devcat-jp/SplitKeyboard/(list of files, drawings)

Other design files:
KiCaD/KeyBoard_L/20240218_keyboard.dsn
KiCaD/KeyBoard_R/20240224_KeyBoard_R.dsn
