devcat-jp/SplitKeyboard/KiCaD/KeyBoard_L/20240218_keyboard.kicad_pcb

## KiCad design KiCaD/KeyBoard_L/20240218_keyboard.kicad_pcb (2024-03-23)

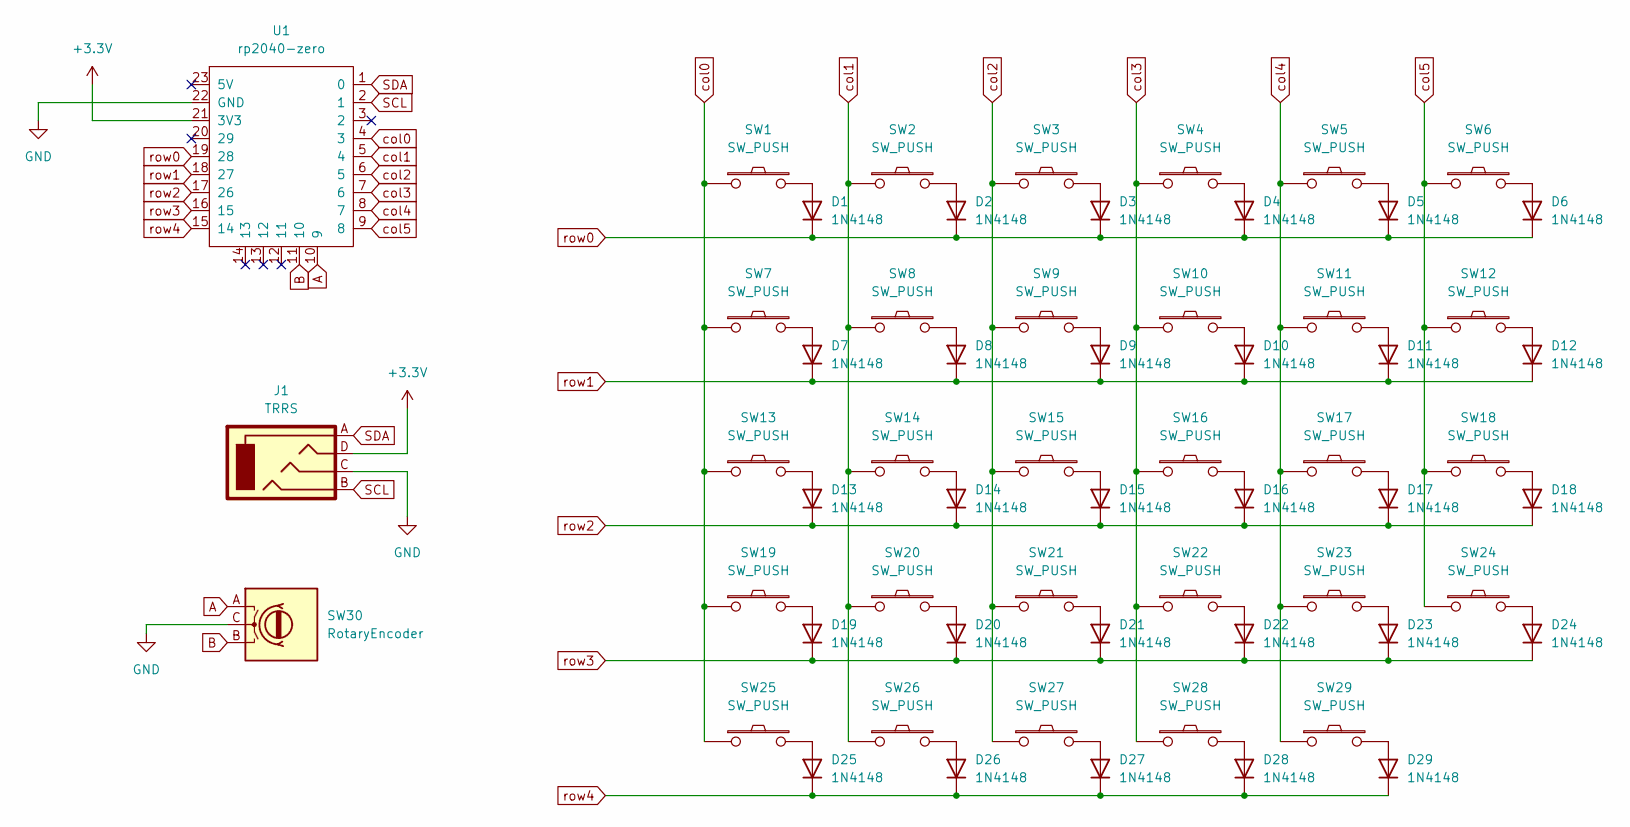
[picture p1: schematic 20240218_keyboard.kicad_sch]

Parts:
D1, D2, D3, D4, D5, D6, D7, D8, D9, D10, D11, D12, D13, D14, D15, D16, D17, D18, D19, D20, D21, D22, D23, D24, D25, D26, D27, D28, D29: 1N4148; D3_SMD_v2
J1: TRRS; MJ-4PP-9_1side
SW1, SW2, SW3, SW4, SW5, SW6, SW8, SW9, SW10, SW11, SW12, SW14, SW15, SW16, SW17, SW18, SW20, SW21, SW22, SW23, SW24, SW26, SW27, SW28: SW_PUSH; SW_Hotswap_Kailh_MX_1.00u
SW7: SW_PUSH; SW_Hotswap_Kailh_MX_1.25u
SW13, SW25, SW29: SW_PUSH; SW_Hotswap_Kailh_MX_1.50u
SW19: SW_PUSH; SW_Hotswap_Kailh_MX_1.75u
SW30: RotaryEncoder; RotaryEncoder_EC11-Switch
U1: rp2040-zero; rp2040-zero-tht

Connections:
+3.3V: J1.D, U1.21 (3V3)
A: SW30.A, U1.10 (9)
B: SW30.B, U1.11 (10)
GND: J1.C, SW30.C, U1.22 (GND)
unnamed: D1.2 (A), SW1.2
unnamed: D2.2 (A), SW2.2
unnamed: D3.2 (A), SW3.2
unnamed: D4.2 (A), SW4.2
unnamed: D5.2 (A), SW5.2
unnamed: D6.2 (A), SW6.2
unnamed: D7.2 (A), SW7.2
unnamed: D8.2 (A), SW8.2
unnamed: D9.2 (A), SW9.2
unnamed: D10.2 (A), SW10.2
unnamed: D11.2 (A), SW11.2
unnamed: D12.2 (A), SW12.2
unnamed: D13.2 (A), SW13.2
unnamed: D14.2 (A), SW14.2
unnamed: D15.2 (A), SW15.2
unnamed: D16.2 (A), SW16.2
unnamed: D17.2 (A), SW17.2
unnamed: D18.2 (A), SW18.2
unnamed: D19.2 (A), SW19.2
unnamed: D20.2 (A), SW20.2
unnamed: D21.2 (A), SW21.2
unnamed: D22.2 (A), SW22.2
unnamed: D23.2 (A), SW23.2
unnamed: D24.2 (A), SW24.2
unnamed: D25.2 (A), SW25.2
unnamed: D26.2 (A), SW26.2
unnamed: D27.2 (A), SW27.2
unnamed: D28.2 (A), SW28.2
unnamed: D29.2 (A), SW29.2
SCL: J1.B, U1.2 (1)
SDA: J1.A, U1.1 (0)
col0: SW1.1, SW7.1, SW13.1, SW19.1, SW25.1, U1.4 (3)
col1: SW2.1, SW8.1, SW14.1, SW20.1, SW26.1, U1.5 (4)
col2: SW3.1, SW9.1, SW15.1, SW21.1, SW27.1, U1.6 (5)
col3: SW4.1, SW10.1, SW16.1, SW22.1, SW28.1, U1.7 (6)
col4: SW5.1, SW11.1, SW17.1, SW23.1, SW29.1, U1.8 (7)
col5: SW6.1, SW12.1, SW18.1, SW24.1, U1.9 (8)
row0: D1.1 (K), D2.1 (K), D3.1 (K), D4.1 (K), D5.1 (K), D6.1 (K), U1.19 (28)
row1: D7.1 (K), D8.1 (K), D9.1 (K), D10.1 (K), D11.1 (K), D12.1 (K), U1.18 (27)
row2: D13.1 (K), D14.1 (K), D15.1 (K), D16.1 (K), D17.1 (K), D18.1 (K), U1.17 (26)
row3: D19.1 (K), D20.1 (K), D21.1 (K), D22.1 (K), D23.1 (K), D24.1 (K), U1.16 (15)
row4: D25.1 (K), D26.1 (K), D27.1 (K), D28.1 (K), D29.1 (K), U1.15 (14)

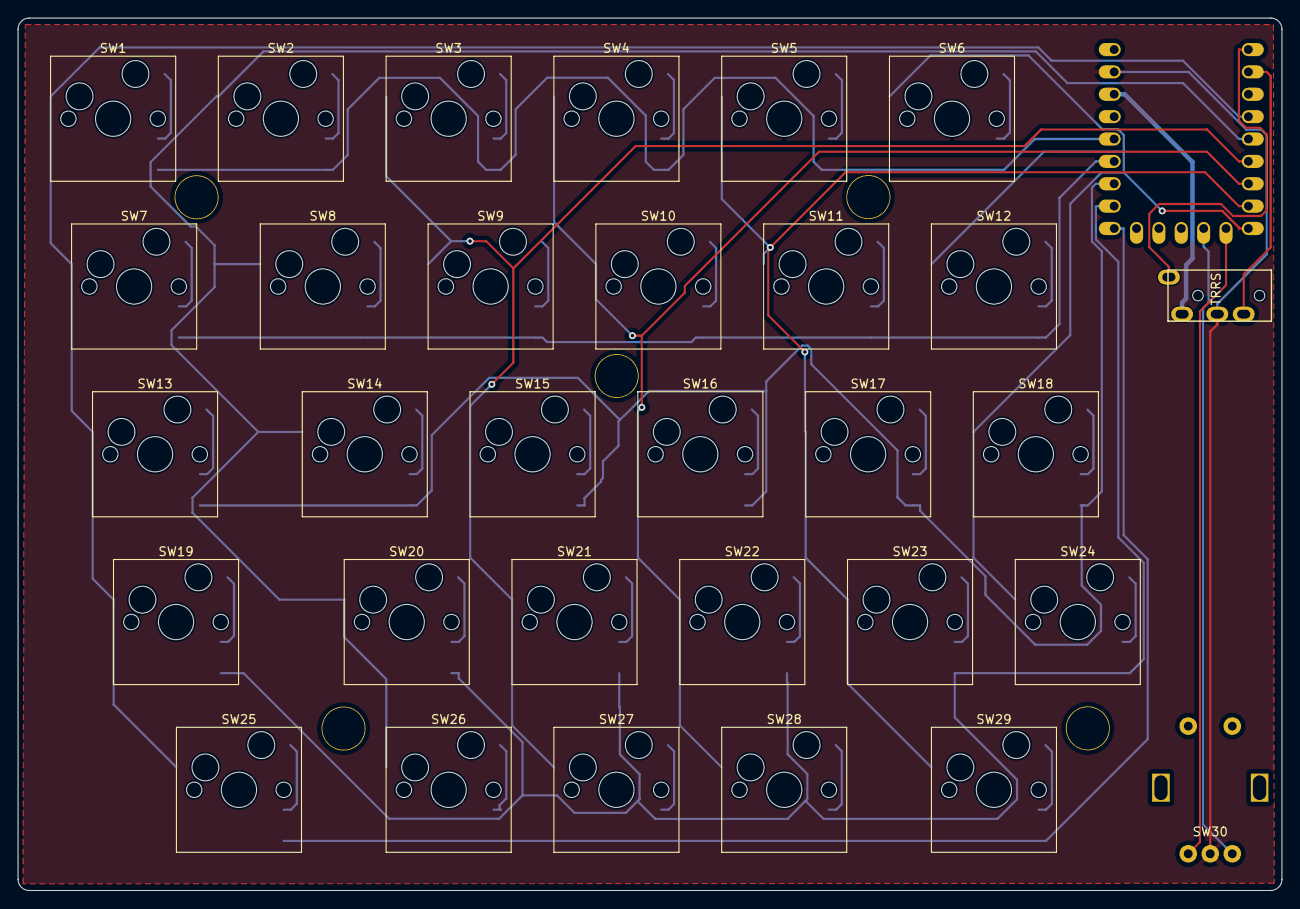
[picture p2: board 20240218_keyboard.kicad_pcb from above]

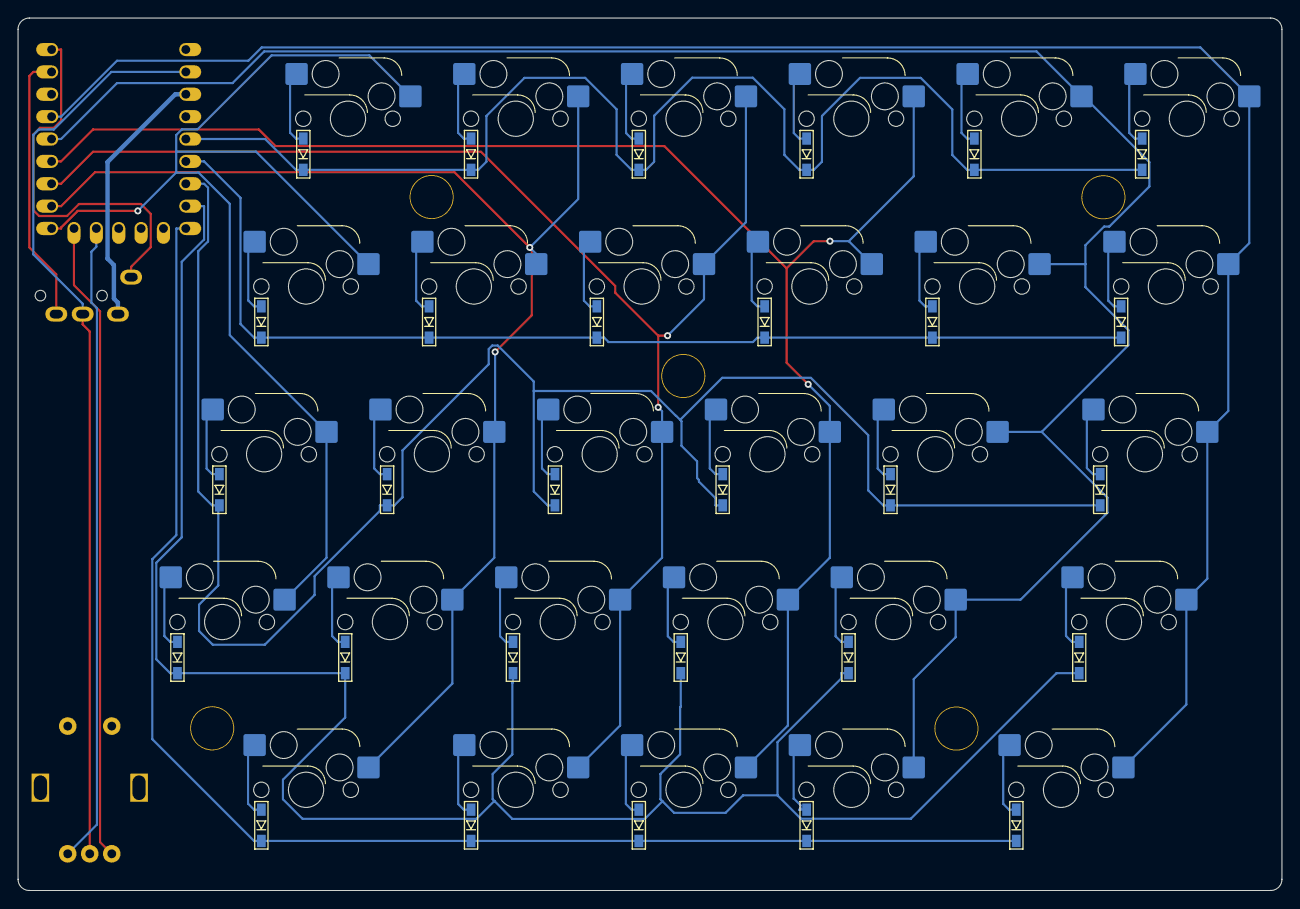
[picture p3: board 20240218_keyboard.kicad_pcb from below]

Board: 2 copper layers, 143.5 x 99.1 mm, 66 parts (29 on the bottom side), 46 nets.

Other parts of the board:
Ref01, Ref02, Ref03, Ref04, Ref05: Val**; HOLE
