devcat-jp/SplitKeyboard/(commit log)

2024-03-23 [add] 成果物登録
    [20240218_keyboard.dsn, 20240218_keyboard.kicad_pcb, 20240218_keyboard.kicad_sch, 20240224_KeyBoard_R.dsn, 20240224_KeyBoard_R.kicad_pcb, 20240224_KeyBoard_R.kicad_sch]
2024-03-24 [mod] スレーブ側の入力情報をビットで送信
2024-03-24 [mod] マルチスレッド化と通信確認用のバイト追加
2024-03-31 [mod] マウス機能試作
2024-04-03 [mod] キーアサイン変更
2024-04-09 [mod ] LED点灯を削除
2024-04-09 [mod] マウス系の機能を削除
2024-04-10 [mod] キー入力処理を見直し
2024-04-16 [mod] キー押しっぱなしの処理修正、およびWindwosキーの押しっぱなし処理追加
2024-04-16 [mod] 裏レイヤにバックスペースを追加
2024-04-16 [mod] 特殊キーは両方のレイヤで同じキーとする
2024-04-16 [mod] 裏レイヤーにFキーを設定
